gabrevelli/mad_simon/README.md

Polytech

Ce projet est réalisé dans le cadre de la formation de prépa intégrée de Polytech'Nice Sophia

# PEIP2_Arduino_Exemple
Exemple de projet Github pour les projets Arduino PEIP2

WallE

# Description du projet

Description du projet :

c'est un jeu interactif entre le téléphone et le jeu :
le but est de reproduire les actions qui se passent sur le jeu avec son téléphone :
le jeu va être diviser en 6 parties, toutes avec une lumière et un son qui lui est propre.
Lorsque le jeu commence, le programme va faire une suite de son+lumière que le joueur devra reproduire.

L'émeteur de son :

on pourrai utiliser la fonction tone () de l'arduino pour générer un son différent

# Materiel utilisé

Notre projet est basé sur une carte Arduino Xplained d'Atmel, on aura besoin aussi de 6 led RVB, un emeteur de son (ex : piezzo buzzer), 
ainsi qu'une puce bluetooth

# Liens utiles

Pour l'emeteur de son :https://programmingelectronics.com/an-easy-way-to-make-noise-with-arduino-using-tone/
