gabrevelli/mad_simon/1ere presentation.pdf

## Mad Simon

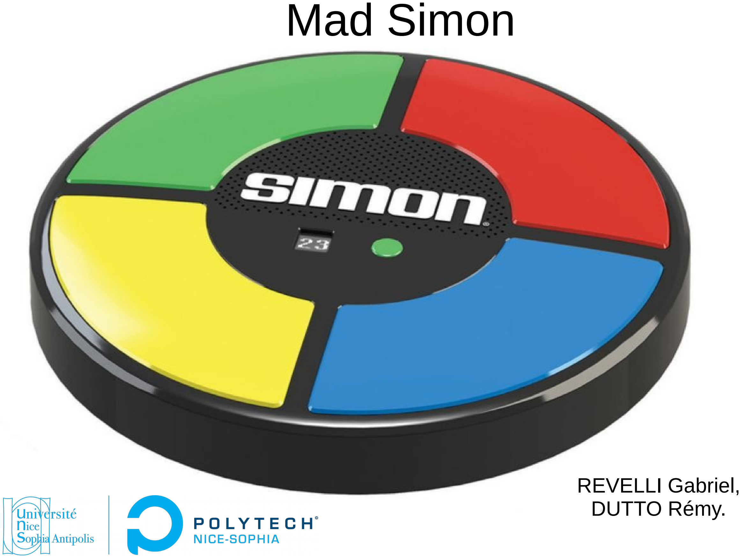
[picture p19: page 1]

REVELLI Gabriel,
DUTTO Rémy.

## Sommaire

- Motivations
- Matériel nécessaire
- Fonctions
- Planning (Diagramme de Gannt)
- Conclusion

## Motivation, Objectifs

- Faire un objet ludique et connecté.
- Faire en sorte qu’il puisse être commercialisé.
- Améliorer le jeu déjà existant.

## Matériel nécessaire

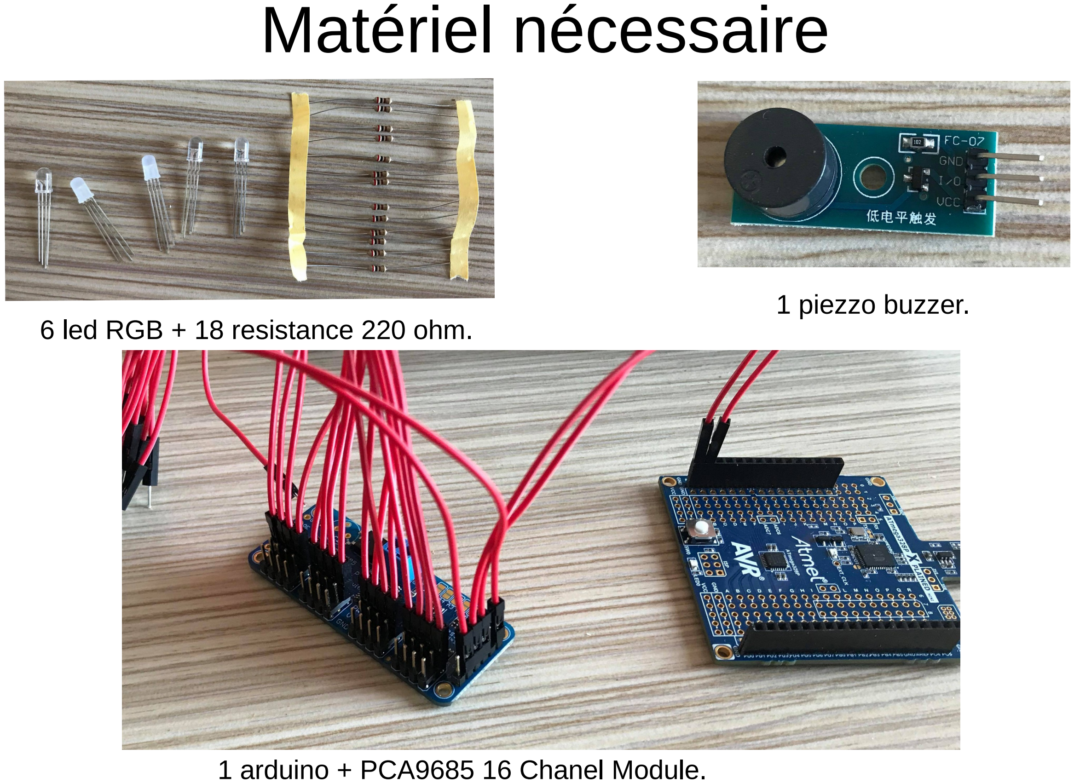
[picture p20: page 4]

6 led RGB + 18 resistance 220 ohm.

1 piezzo buzzer.

1 arduino + PCA9685 16 Chanel Module.

## Fonctions

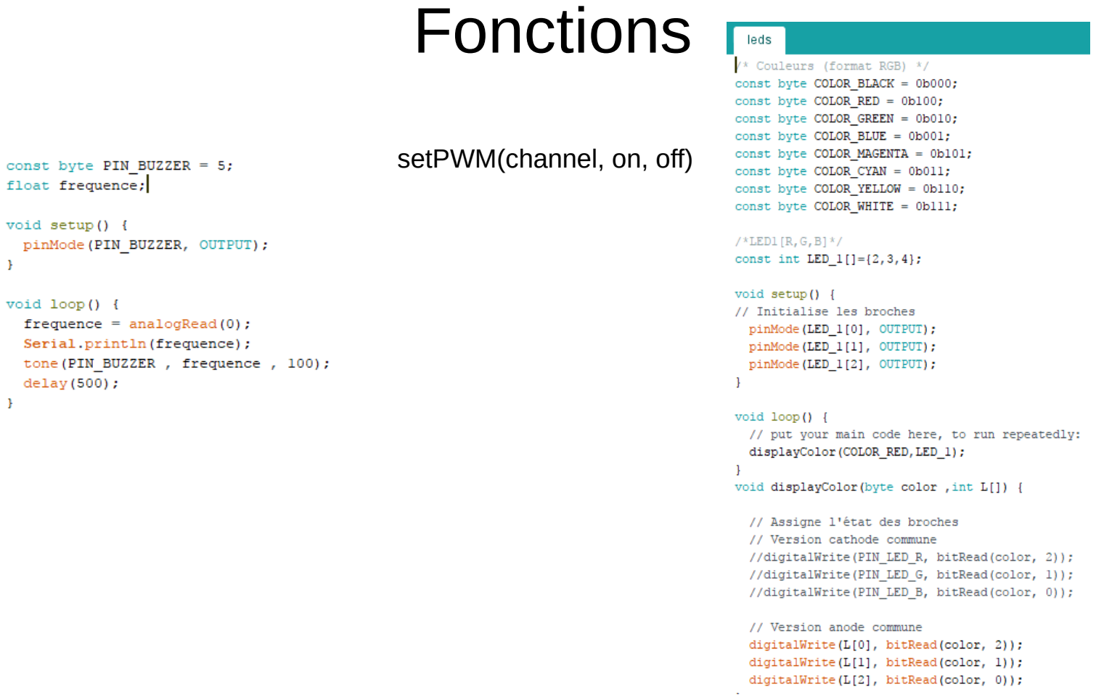
[picture p21: page 5]

setPWM(channel, on, off)

## Diagramme de Gantt

amelioration

disign

-interface graphique

-code

bluetooth

- assemblage
- buzzer
- led

code

- assemblage
- utilisation

buzzer

- assemblage
- utilisation

led

0 | 0,5 | 1 | 1,5 | 2 | 2,5 | 3 | 3,5 | 4 | 4,5 | 5

Mois(debut janvier a fin mai).

Certaines modifications peuvent être effectué.

## Conclusion

- Projet simple au premier abord mais…
- Changement de projet.
- Difficultés.
